mechanart/ghz_sig_gen/board/README

This folder contains schematics and layout files for the primary DDS board.

Additionally, we intend to supply projects for many EDA tools to produce the 
same gerbers.
