mechanart/ghz_sig_gen/board/schematics/README

PDF copies of the schematics generated from the master Altium (likely) 
project are stored here for reference.
