mechanart/ghz_sig_gen/board/gerbers/README

Final output gerbers for the production board go here.
