mechanart/ghz_sig_gen/(list of files, drawings)

Other design files:
board/pcb/dsg_card.PcbDoc
board/schematics/DCDC_Regulators.SchDoc
board/schematics/DDS.SchDoc
board/schematics/Divider.SchDoc
board/schematics/DSG_Card_TopLevel.SchDoc
board/schematics/EasyPHI_Core.SchDoc
board/schematics/LDO_Regulators.SchDoc
board/schematics/Reconstruction_Filter.SchDoc
board/sig_gen_card.PrjPcb
