mechanart/ghz_sig_gen/(commit log)

2014-04-20 Adding a Bill of Materials. Currently just outlining some major pieces. Attempting to stay under 300pins...
    [gsg_bom.csv]
2014-04-22 Added a sketch of a 3-voltage power system. Will check in the Webench files if we choose to go with this solution. Bumping up against pin limits already...
    [gsg_bom.csv]
2014-04-28 Added .DS_Store to gitignore.
    Added AD9914 footprints as exported by Ultra Librarian...
2014-04-29 Adding footprints for ADCLK905 (rev 2)
2014-05-02 Adding base Altium project including start of main board schematic.
    [ad9914_main.SchDoc, ghz_sig_gen_base.PrjPcb]
2014-05-03 Added the AD9914 symbol & footprint import from ADI through Ultra Librarian. Added AD9914 to ad9914_main schematic.
    [ad9914_main.SchDoc, ghz_sig_gen_base.PrjPcb]
2014-05-06 Adding basic power and ground to main schematic.
    [ad9914_main.SchDoc]
2016-01-03 Initial check-in of new Altium project replacing ghz_sig_gen.
    Made good progress on the Easy-PHI template core.
    [AA_Filter.SchDoc, Connector.SchDoc, DDS.SchDoc, DSG_Card_TopLevel.SchDoc, EasyPHI_Core.SchDoc, Microcontroller.SchDoc, Power.SchDoc, ad9914_main.SchDoc]
2016-01-04 Updated J2 with proper footprint for microSD.
    [EasyPHI_Core.SchDoc, dsg_card.PcbDoc, sig_gen_card.PrjPcb]
2016-01-10 Added MAX5924D 12V hotswap controller to Easy-PHI template.
    [EasyPHI_Core.SchDoc, sig_gen_card.PrjPcb]
2016-01-10 Added MAX5925D to template
    [EasyPHI_Core.SchDoc]
2016-01-11 Added decoupling caps and SD card VMCI switch (Q1)
    [EasyPHI_Core.SchDoc, sig_gen_card.PrjPcb]
2016-01-11 Added TPS7A4901 LDO
    [EasyPHI_Core.SchDoc]
2016-01-11 Added 24LC64 to template.
    [EasyPHI_Core.SchDoc]
2016-01-31 Added U9 - SN65LVDM176DGKR backplane clock differential receiver.
    [EasyPHI_Core.SchDoc]
2016-02-01 Added pushbutton (USR_BUTTN) and RGB LED to Core template.
    [EasyPHI_Core.SchDoc]
2016-02-01 Added P1 - CONN_8 8-pin header for Arduino on EasyPHI template.
    [EasyPHI_Core.SchDoc, sig_gen_card.PrjPcb]
2016-02-06 Added U12 backplane connector to EasyPHI template core page.
    [EasyPHI_Core.SchDoc]
2016-02-07 Finished EasyPHI Core page of template. All components have footprints and are pushed to PCB. Start basic component placement.
    [DDS.SchDoc, DSG_Card_TopLevel.SchDoc, EasyPHI_Core.SchDoc, sig_gen_card.PrjPcb]
2016-02-09 EasyPHI Core cleanup - should now be complete. Import updates to PCB - position backplane Connector Wired up R5 - slew limiting resistor on top level.
    [DSG_Card_TopLevel.SchDoc, EasyPHI_Core.SchDoc]
2016-02-16 Added decoupling capacitors for AD9914 based on EVK. Renamed AA_Filter to Reconstruction_Filter as it's on the output of a DAC, not input to an ADC.
    [DDS.SchDoc]
2016-02-17 Renamed Reconstruction_Filter to preserve filename extension!
    [DSG_Card_TopLevel.SchDoc, Reconstruction_Filter.SchDoc]
2016-02-17 Added most of the DAC reconstruction filter. 7th-order elliptic (Cauer) low-pass with Coilcraft inductors and Murata C0G caps.
    [DDS.SchDoc, DSG_Card_TopLevel.SchDoc, Reconstruction_Filter.SchDoc, sig_gen_card.PrjPcb]
2016-02-17 Adding clock multiplier / generator schematic page. Adding harness for balanced RF.
    [Clock_Multiplier.SchDoc]
2016-02-18 Added TC1-1-13 transmission line filter as Balun for DDS output. 0.1uF DC-blocking caps also added because transmission line transformer.
    [Reconstruction_Filter.SchDoc]
2016-02-29 Moved to ceramic resonator based VCO for ref clock - removed multiplier page. Added CVCO55 for 3.5GHz reference. Added ADCLK905 to drive PECL refclk input.
    [Clock_Multiplier.SchDoc, DDS.SchDoc, sig_gen_card.PrjPcb]
2016-02-29 Nearly finished wiring up DDS for serial operation. Added two Samtec QSE 40-pin connectors for later parallel use of AD9914. Updated pcb with latest from schematic.
    [DDS.SchDoc, DSG_Card_TopLevel.SchDoc, sig_gen_card.PrjPcb]
2016-03-02 Added LT3042s for DDS power. Added trial net-ties for PCB ballast resistors.
    [Power.SchDoc, sig_gen_card.PrjPcb]
2016-03-02 Played with some design rules to get the PCB trace resistor (net tie) component to work. 2/4 no complaints - odd - may yet revert to SMT components for this ballast current balancing.
    [Power.SchDoc, sig_gen_card.PrjPcb]
2016-03-05 Playing around with SYNC_CLK and updates to PCB. Tried to get net-ties working again, going to SMT resistors for space reasons.
    [DDS.SchDoc, sig_gen_card.PrjPcb]
2016-03-06 Added missing schottky on 3.3V buck regulator for EasyPHI Template. Added a couple other TVSs (12V, 3.3V) that were missing from template.
    [EasyPHI_Core.SchDoc]
2016-03-08 Updates to power circuits. Paralleled LT3042s for analog 3.3V
    [DDS.SchDoc, DSG_Card_TopLevel.SchDoc, Power.SchDoc, sig_gen_card.PrjPcb]
2016-03-12 Added a divide-by-5 digital divider to further scale the RefClk to within SAM3x8E counting range.
    [Divider.SchDoc, sig_gen_card.PrjPcb]
2016-03-13 Added more LDOs for the other DDS voltages.
    [DDS.SchDoc, Power.SchDoc, sig_gen_card.PrjPcb]
2016-03-13 Disambiguated SET and CDC for the two sets of paralleled LT3042s.
    [Power.SchDoc]
2016-03-14 Finished divide-by-5 with 50% duty cycle output for measuring the SYNC_CLK (indirectly the REF_CLK) frequency.
    [DSG_Card_TopLevel.SchDoc, Divider.SchDoc, sig_gen_card.PrjPcb]
2016-04-03 Renamed Power to LDO_Regulators as we'll have both DC-DC switchers and LDOs in this design (outside of template). Added harnesses. Deleted old Connector and Microcontroller sheets.
    [Connector.SchDoc, DCDC_Regulators.SchDoc, LDO_Regulators.SchDoc, Microcontroller.SchDoc, Power.SchDoc]
